rahulsarchive/cncdragknife/Dragknife/toolbody.stl

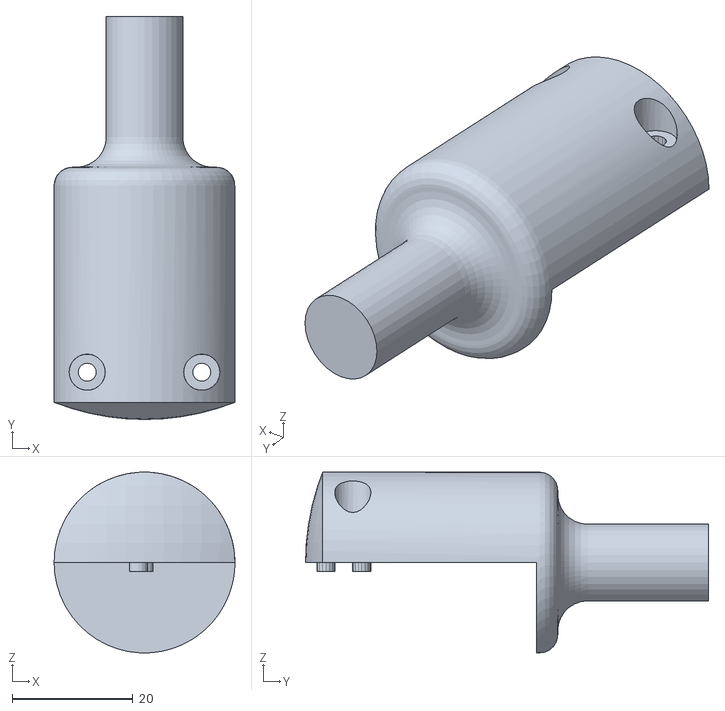
[picture p12: CAD file, 2018-06-22]
Dragknife/toolbody.stl
30.0 x 66.8 x 30.0
