rahulsarchive/cncdragknife/Dragroller/blade holder.stl

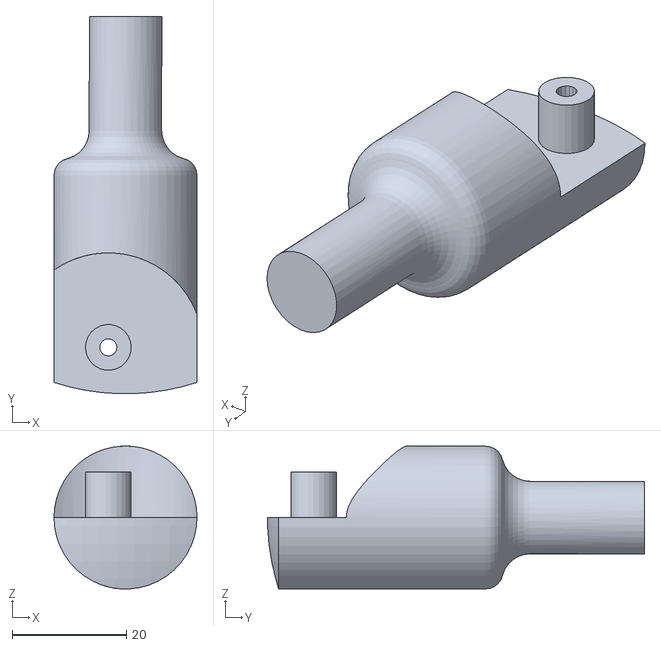
[picture p13: CAD file, 2018-06-22]
Dragroller/blade holder.stl
25.0 x 66.0 x 25.0
