rahulsarchive/cncdragknife/Dragknife/blade holder.stl

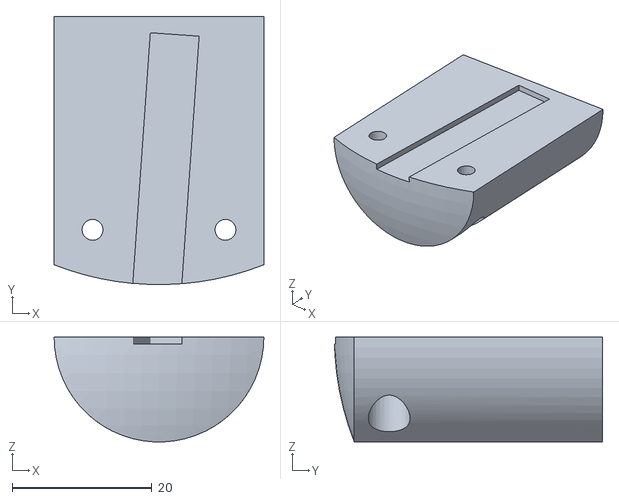
[picture p14: CAD file, 2018-06-22]
Dragknife/blade holder.stl
30.0 x 38.3 x 15.0
