rahulsarchive/cncdragknife/Dragroller/Body30.stl

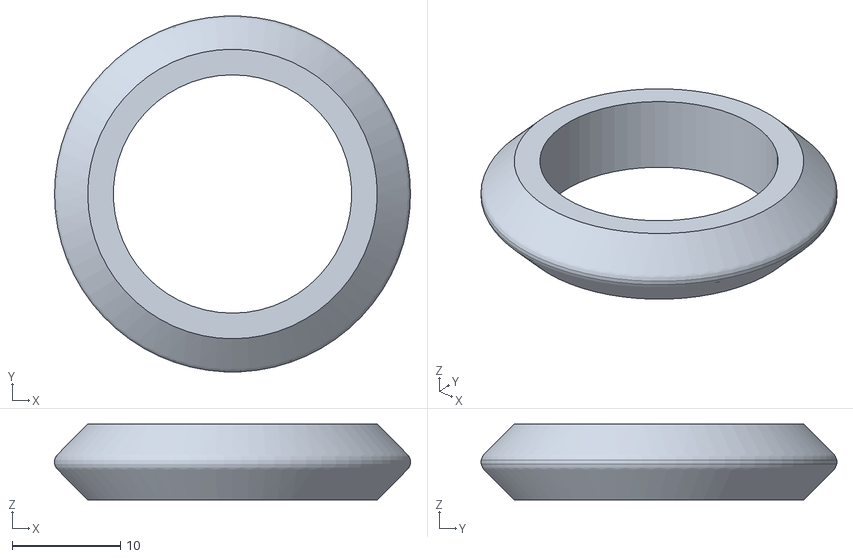
[picture p15: CAD file, 2018-06-22]
Dragroller/Body30.stl
32.9 x 32.8 x 7.00
